Marawan29/PIDControllerProject/(list of files, drawings)

Other design files:
Multisim/All circuits.ms14
